MUN-Baja/2019_Comp/2019-05-26T074602.xlsx

Index | Quantity | Part Number | Manufacturer Part Number | Description | Customer Reference | Available | Backorder | Unit Price | Extended Price CAD
1 | 20 | 277-11117-ND | 3240016 | CONN RING CIRC 16-20AWG M3 CRIMP | CRIMP1 | 20 | 0 | 0.402 | 8.04
2 | 10 | 36-3522-ND | 3522 | FUSE CLIP BLADE 500V 30A PCB | F1 F2 F3 F4 F5 | 10 | 0 | 0.289 | 2.89
3 | 18 | 36-7771-ND | 7771 | TERM SCREW M3 4 PIN PCB | J1 J2 J3 J4 J5 J7 J8 J9 J10 J11 | 18 | 0 | 0.634 | 11.41
4 | 3 | F4193-ND | 0287003.PXCN | FUSE AUTO 3A 32VDC BLADE |  | 3 | 0 | 0.41 | 1.23
5 | 2 | F4199-ND | 0287010.PXCN | FUSE AUTOMOTIVE 10A 32VDC BLADE |  | 2 | 0 | 0.41 | 0.82
6 | 2 | F4201-ND | 0287020.PXCN | FUSE AUTOMOTIVE 20A 32VDC BLADE |  | 2 | 0 | 0.41 | 0.82
7 | 1 | F4197-ND | 0287005.PXCN | FUSE AUTO 5A 32VDC BLADE ATO/ATC |  | 1 | 0 | 0.41 | 0.41
8 | 1 | F4200-ND | 0287015.PXCN | FUSE AUTOMOTIVE 15A 32VDC BLADE |  | 1 | 0 | 0.41 | 0.41
9 | 1 | F4203-ND | 0287040.PXCN | FUSE AUTOMOTIVE 40A 32VDC BLADE |  | 1 | 0 | 0.41 | 0.41
10 | 1 | F4198-ND | 028707.5PXCN | FUSE AUTOMOTIVE 7.5A 32VDC BLADE |  | 1 | 0 | 0.41 | 0.41
11 | 2 | F4191-ND | 0287001.PXCN | FUSE AUTO 1A 32VDC BLADE |  | 2 | 0 | 0.41 | 0.82
12 | 4 | RPC3022-ND | CBTS105A | HEX STANDOFF M3 NYLON 22MM |  | 4 | 0 | 2.03 | 8.12
13 | 25 | 455-2266-ND | XHP-2 | CONN HOUSING 2.5MM 2POS |  | 25 | 0 | 0.0952 | 2.38
14 | 25 | 455-2247-ND | B2B-XH-A(LF)(SN) | CONN HEADER VERT 2POS 2.5MM |  | 25 | 0 | 0.205 | 5.13
15 | 100 | 455-1135-1-ND | SXH-001T-P0.6 | CONN SOCKET 22-28AWG CRIMP TIN |  | 100 | 0 | 0.0561 | 5.61
16 | 10 | 455-2219-ND | XHP-3 | CONN HOUSING 2.5MM XH 3POS |  | 10 | 0 | 0.142 | 1.42
17 | 10 | 455-2248-ND | B3B-XH-A(LF)(SN) | CONN HEADER VERT 3POS 2.5MM |  | 10 | 0 | 0.263 | 2.63
18 | 1 | 455-2268-ND | XHP-5 | CONN HOUSING 2.5MM 5POS |  | 1 | 0 | 0.17 | 0.17
19 | 1 | 455-2270-ND | B5B-XH-A(LF)(SN) | CONN HEADER VERT 5POS 2.5MM |  | 1 | 0 | 0.36 | 0.36
20 | 2 | 1568-1816-ND | PRT-10474 | XT60 CONNECTORS MALE/FEMALE PAIR |  | 2 | 0 | 2.18 | 4.36
21 | 1 | 36-3034-ND | 3034 | BATTERY RETAINER COIN 20MM SMD | BT1 | 1 | 0 | 0.45 | 0.45
22 | 3 | 1276-6471-1-ND | CL21B105KOFNNNG | CAP CER 1UF 16V X7R 0805 | C1 C2 C9 | 3 | 0 | 0.15 | 0.45
23 | 1 | 1276-6464-1-ND | CL21A475KPFNNNG | CAP CER 4.7UF 10V X5R 0805 | C8 | 1 | 0 | 0.19 | 0.19
24 | 1 | 1528-1074-ND | 85 | STACKING HEADER ARDUINO SHIELD | J10 | 1 | 0 | 2.83 | 2.83
25 | 1 | HR1941CT-ND | DM3D-SF | CONN MICRO SD CARD PUSH-PULL | J4 | 1 | 0 | 2.54 | 2.54
26 | 1 | 455-2257-ND | S2B-XH-A(LF)(SN) | CONN HEADER R/A 2POS 2.5MM | J1 | 1 | 0 | 0.25 | 0.25
27 | 1 | 311-0.0ARCT-ND | RC0805JR-070RL | RES SMD 0 OHM JUMPER 1/8W 0805 | R3 | 1 | 0 | 0.15 | 0.15
28 | 2 | 311-200ARCT-ND | RC0805JR-07200RL | RES SMD 200 OHM 5% 1/8W 0805 | R4 R5 | 2 | 0 | 0.15 | 0.30
29 | 2 | 311-4.7KARCT-ND | RC0805JR-074K7L | RES SMD 4.7K OHM 5% 1/8W 0805 | R1 R2 | 2 | 0 | 0.15 | 0.30
30 | 1 | 1727-6331-1-ND | 74HC4050D,653 | IC BUFFER NON-INVERT 6V 16SO | U4 | 1 | 0 | 0.7 | 0.70
31 | 1 | AZ1117EH-3.3TRG1DICT-ND | AZ1117EH-3.3TRG1 | IC REG LINEAR 3.3V 1A SOT223 | U2 | 1 | 0 | 0.66 | 0.66
32 | 1 | 455-2251-ND | B8B-XH-A(LF)(SN) | CONN HEADER VERT 8POS 2.5MM | U5 | 1 | 0 | 0.52 | 0.52
33 | 1 | 535-9034-ND | AB38T-32.768KHZ | CRYSTAL 32.7680KHZ 12.5PF T/H | Y1 | 1 | 0 | 0.26 | 0.26
34 | 1 | L10005-ND | 5100H5 | LED GREEN 1/4" HOLE PANEL MOUNT |  | 1 | 0 | 2.15 | 2.15
35 | 1 | L10001-ND | 5100H1 | LED RED 1/4" HOLE PANEL MOUNT |  | 1 | 0 | 2.15 | 2.15
36 | 1 | 455-1902-ND | XHP-8 | CONN HOUSING XH 8POS 2.5MM |  | 1 | 0 | 0.23 | 0.23
37 | 1 | 455-2251-ND | B8B-XH-A(LF)(SN) | CONN HEADER VERT 8POS 2.5MM |  | 1 | 0 | 0.52 | 0.52
38 | 10 | 732-8026-1-ND | 885012207016 | CAP CER 0.1UF 10V X7R 0805 | C5 C6 C7 C10 C11 C12 | 10 | 0 | 0.064 | 0.64
39 | 10 | 587-1451-1-ND | EMK105B7104KV-F | CAP CER 0.1UF 16V X7R 0402 | C3 C4 | 10 | 0 | 0.032 | 0.32
40 | 10 | 455-2267-ND | XHP-4 | CONN HOUSING 2.5MM 4POS |  | 10 | 0 | 0.142 | 1.42
41 | 10 | 455-2249-ND | B4B-XH-A(LF)(SN) | CONN HEADER VERT 4POS 2.5MM |  | 10 | 0 | 0.282 | 2.82
