MUN-Baja/2019_Comp/Models/Speedo CLAMP.SLDPRT

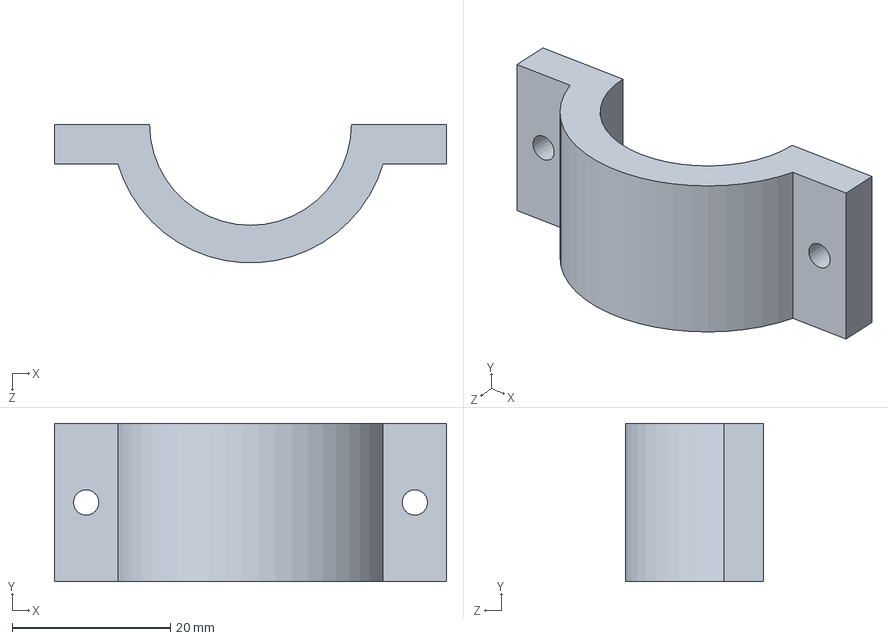
[picture p6: CAD file, 2019-06-01]
Models/Speedo CLAMP.SLDPRT
49.5 x 20.0 x 17.5 mm
