MUN-Baja/2019_Comp/Models/STLs/Speedo Mount_PART2.STL

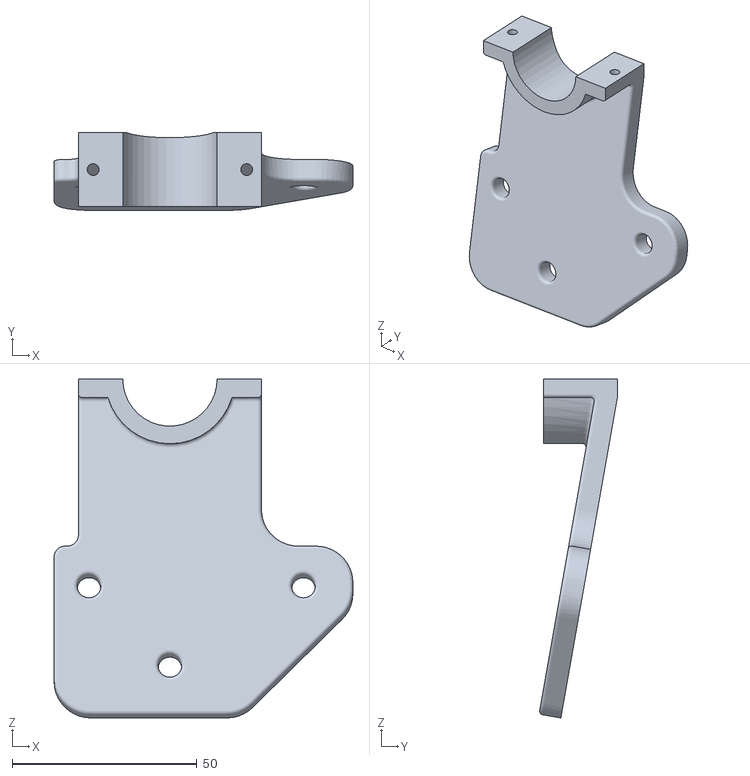
[picture p7: CAD file, 2019-06-01]
Models/STLs/Speedo Mount_PART2.STL
80.8 x 21.0 x 91.7
