MUN-Baja/2019_Comp/Models/Battery_Cover.SLDPRT

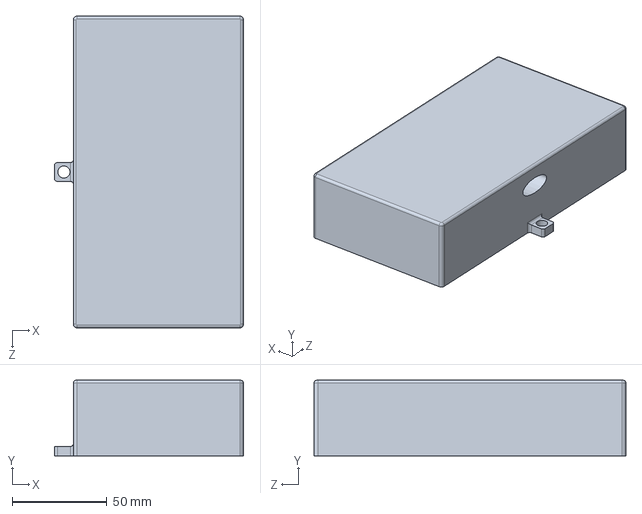
[picture p8: CAD file, 2019-05-29]
Models/Battery_Cover.SLDPRT
100.0 x 40.0 x 165.0 mm
