MUN-Baja/2019_Comp/Models/Battery_Base.SLDPRT

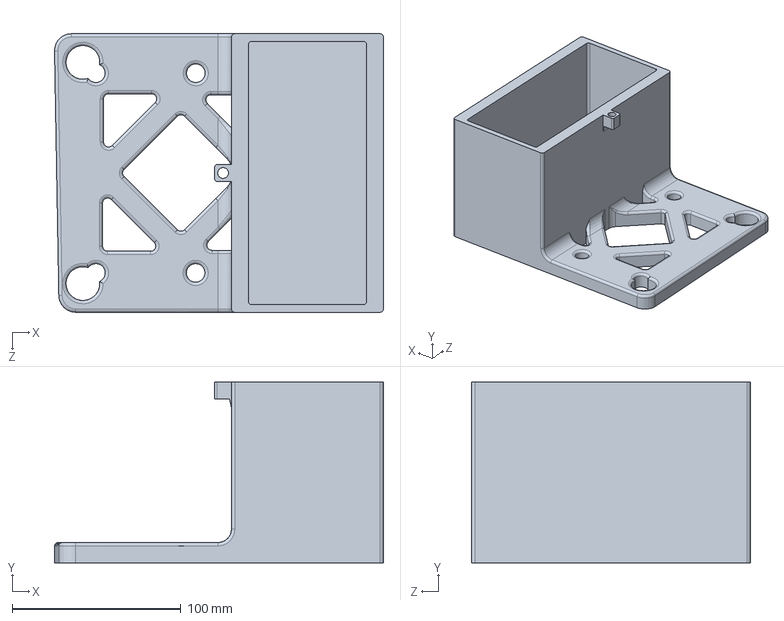
[picture p9: CAD file, 2019-05-29]
Models/Battery_Base.SLDPRT
194.8 x 107.0 x 165.0 mm
