MUN-Baja/2019_Comp/(list of files, cad)

Other CAD files:
Models/Speedo Mount.SLDPRT
Models/STLs/Battery_Base.STL
Models/STLs/Battery_Cover.STL
Models/STLs/Speedo CLAMP.STL
