MUN-Baja/2019_Comp/ControllerPCB/DOC/ControllerPCB.pdf

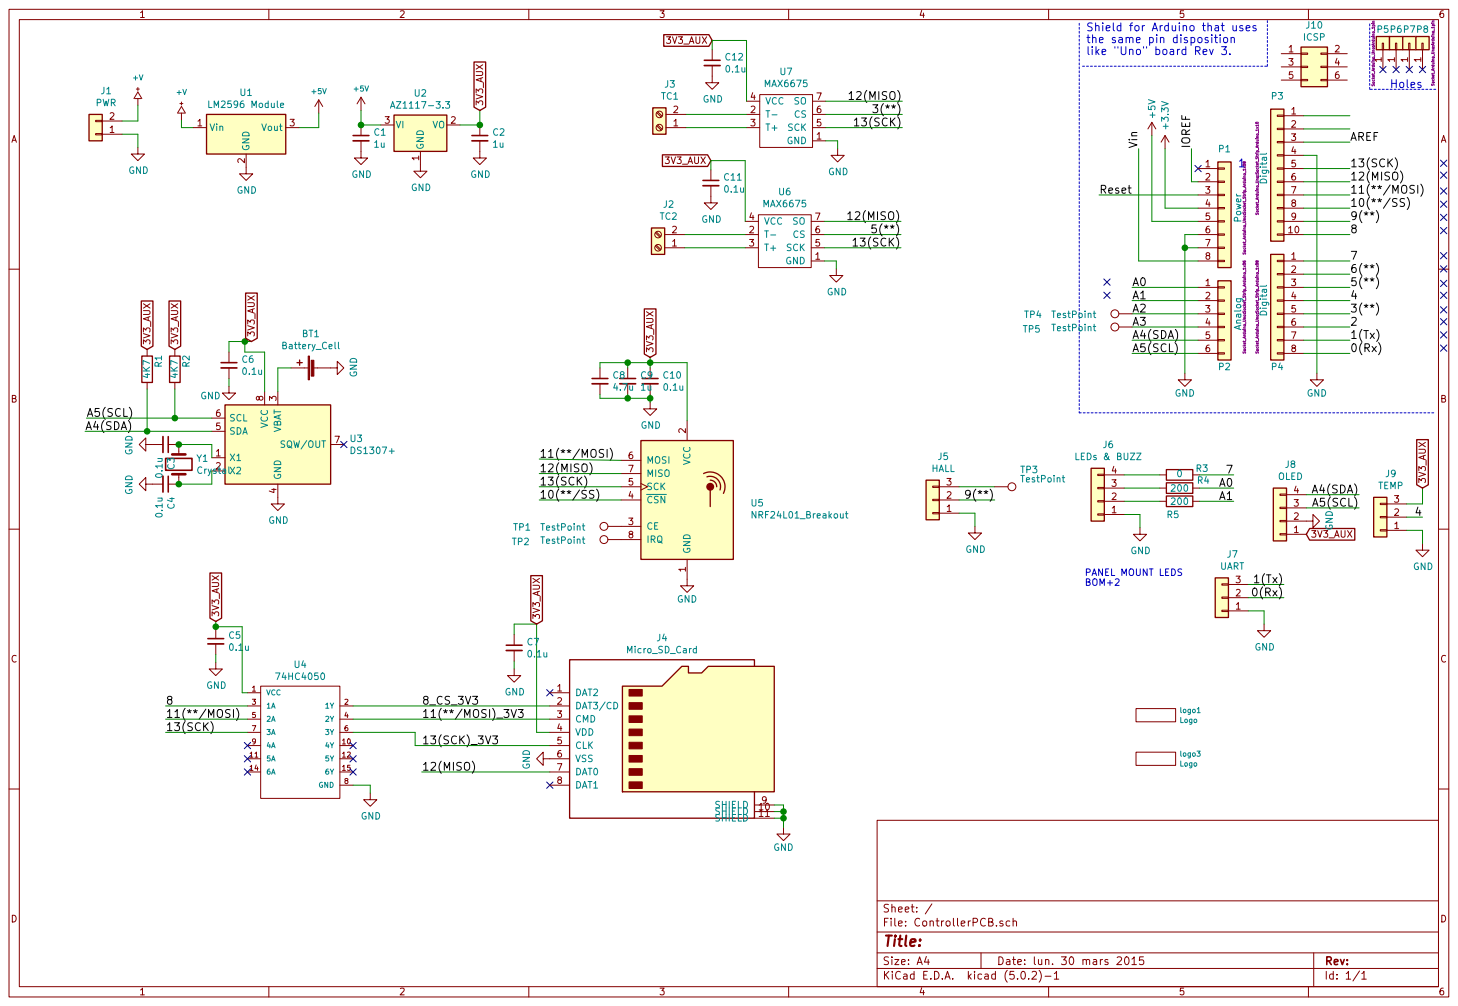
[picture p10: page 1]

the same pin disposition
like "Uno" board Rev 3. 1

4 SDA 5 SCL 6 SQW/OUT 7 VCC

2 CE 3 CSN 4 SCK 5 MOSI 6 MISO 7
