MUN-Baja/2019_Comp/FusePCB/FusePCB.kicad_pcb

## KiCad design FusePCB/FusePCB.kicad_pcb (2019-05-27)

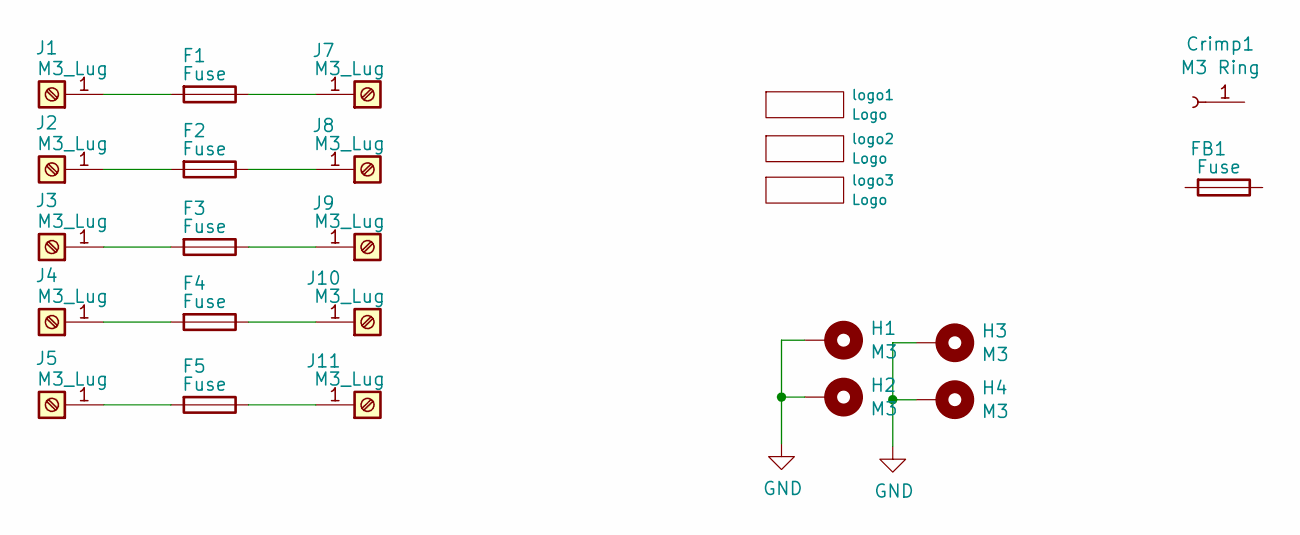
[picture p11: schematic FusePCB.sch]

Parts:
Crimp1: M3 Ring
F1, F2, F3, F4, F5: Fuse; Fuse_ATC_ATO_BLADE
FB1: Fuse
H1, H2, H3, H4: M3; 3.4mm_mounting_hole_SILK
J1, J2, J3, J4, J5, J7, J8, J9, J10, J11: M3_Lug; LVDC_M3_Lug
logo1, logo2: Logo; SN_BLOCK
logo3: Logo; KiCad-Logo_8mm_SilkScreen

Connections:
GND: H1.1, H2.1, H3.1, H4.1
unnamed: F1.1, J7.1
unnamed: F1.2, J1.1
unnamed: F2.1, J8.1
unnamed: F2.2, J2.1
unnamed: F3.1, J9.1
unnamed: F3.2, J3.1
unnamed: F4.1, J10.1
unnamed: F4.2, J4.1
unnamed: F5.1, J11.1
unnamed: F5.2, J5.1

Board: 2 copper layers, 22 parts (1 on the bottom side), 11 nets, no tracks yet.
