MUN-Baja/2019_Comp/PowerPCB/PowerPCB.kicad_pcb

## KiCad design PowerPCB/PowerPCB.kicad_pcb (2019-05-27)

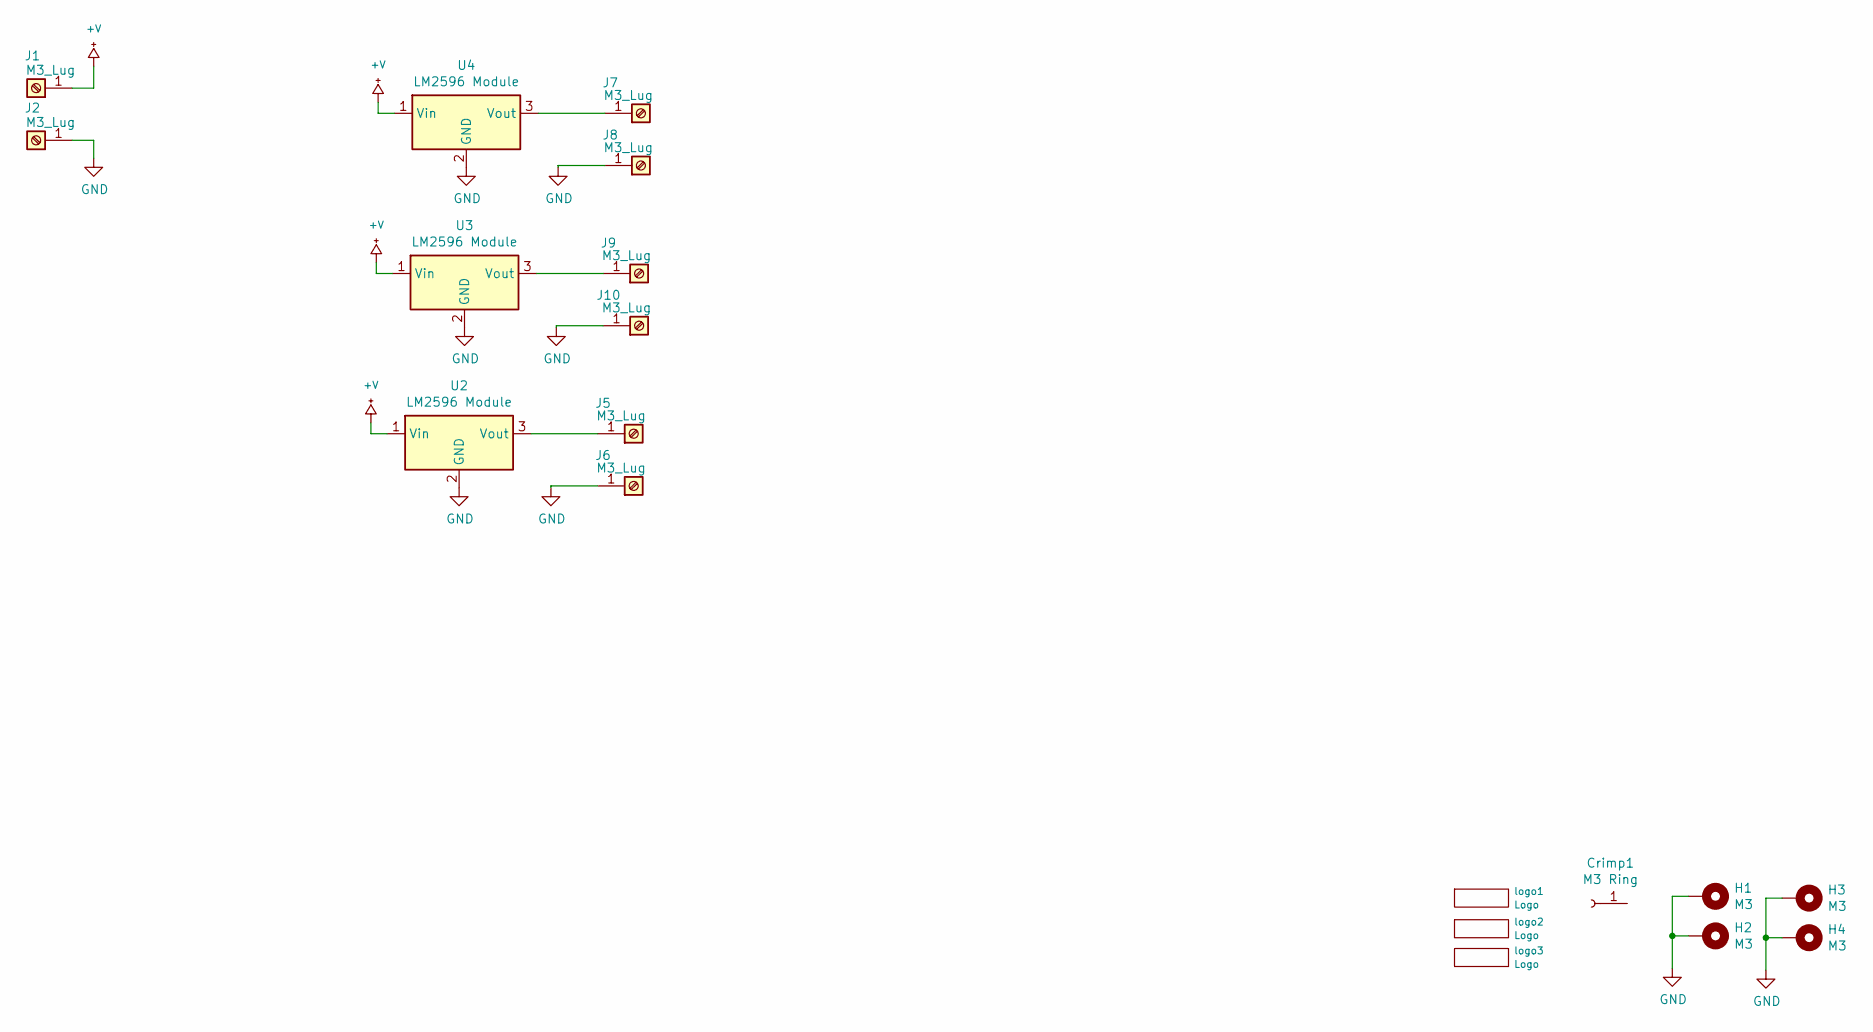
[picture p12: schematic PowerPCB.sch]

Parts:
Crimp1: M3 Ring
H1, H2, H3, H4: M3; 3.4mm_mounting_hole_SILK
J1, J2, J5, J6, J7, J8, J9, J10: M3_Lug; LVDC_M3_Lug
U2, U3, U4: LM2596 Module; LM2596_Module
logo1, logo2: Logo; SN_BLOCK
logo3: Logo; KiCad-Logo_8mm_SilkScreen

Connections:
+V: J1.1, U2.1 (Vin), U3.1 (Vin), U4.1 (Vin)
GND: H1.1, H2.1, H3.1, H4.1, J2.1, J6.1, J8.1, J10.1, U2.2 (GND), U3.2 (GND), U4.2 (GND)
unnamed: J5.1, U2.3 (Vout)
unnamed: J7.1, U4.3 (Vout)
unnamed: J9.1, U3.3 (Vout)

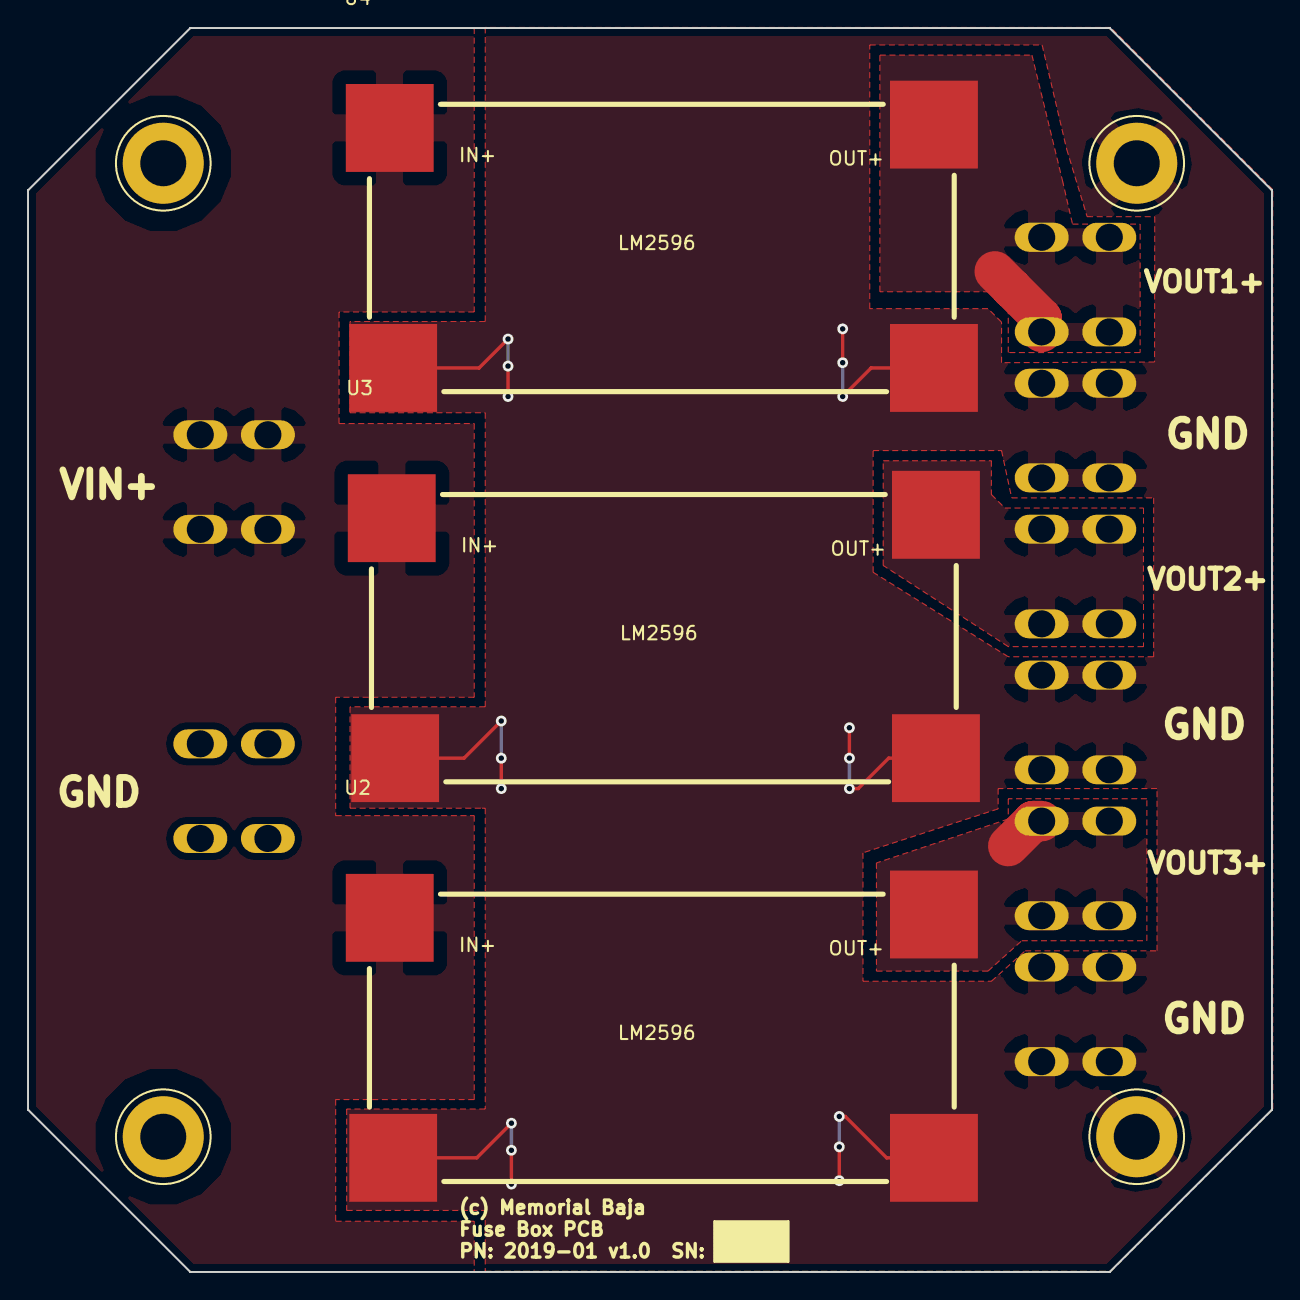
[picture p13: board PowerPCB.kicad_pcb from above]

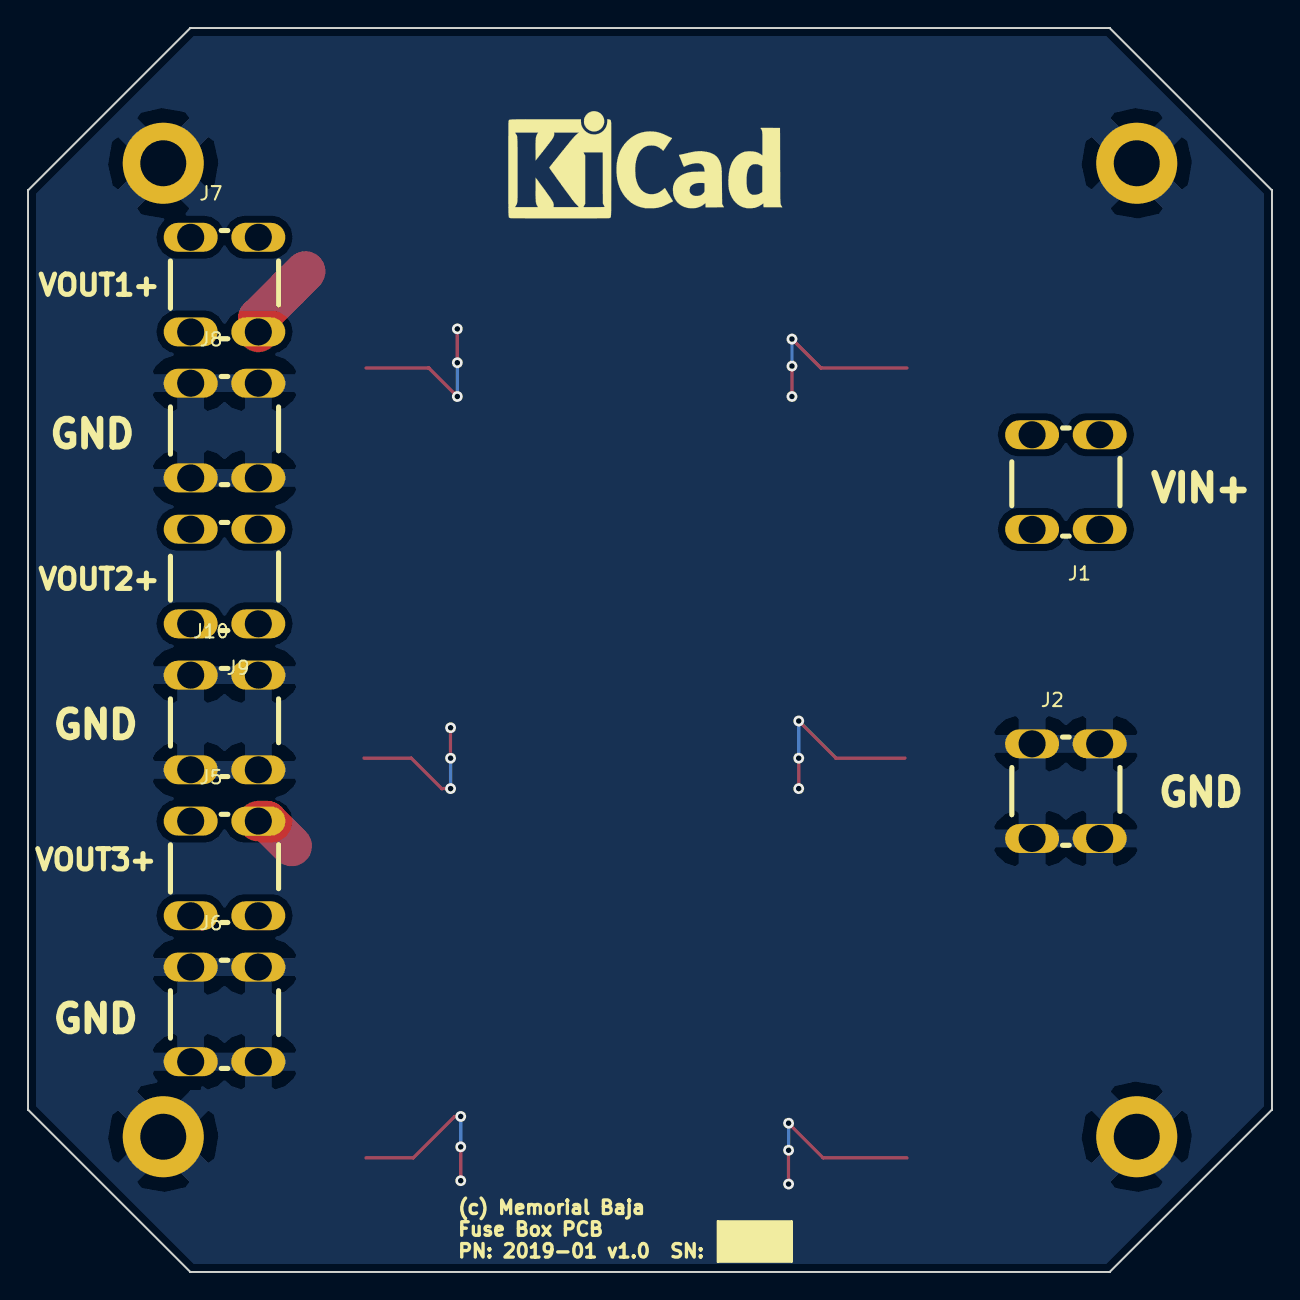
[picture p14: board PowerPCB.kicad_pcb from below]

Board: 2 copper layers, 92.0 x 92.0 mm, 18 parts (10 on the bottom side), 5 nets.
