MUN-Baja/2019_Comp/ControllerPCB/ControllerPCB.kicad_pcb

## KiCad design ControllerPCB/ControllerPCB.kicad_pcb (2019-05-27)

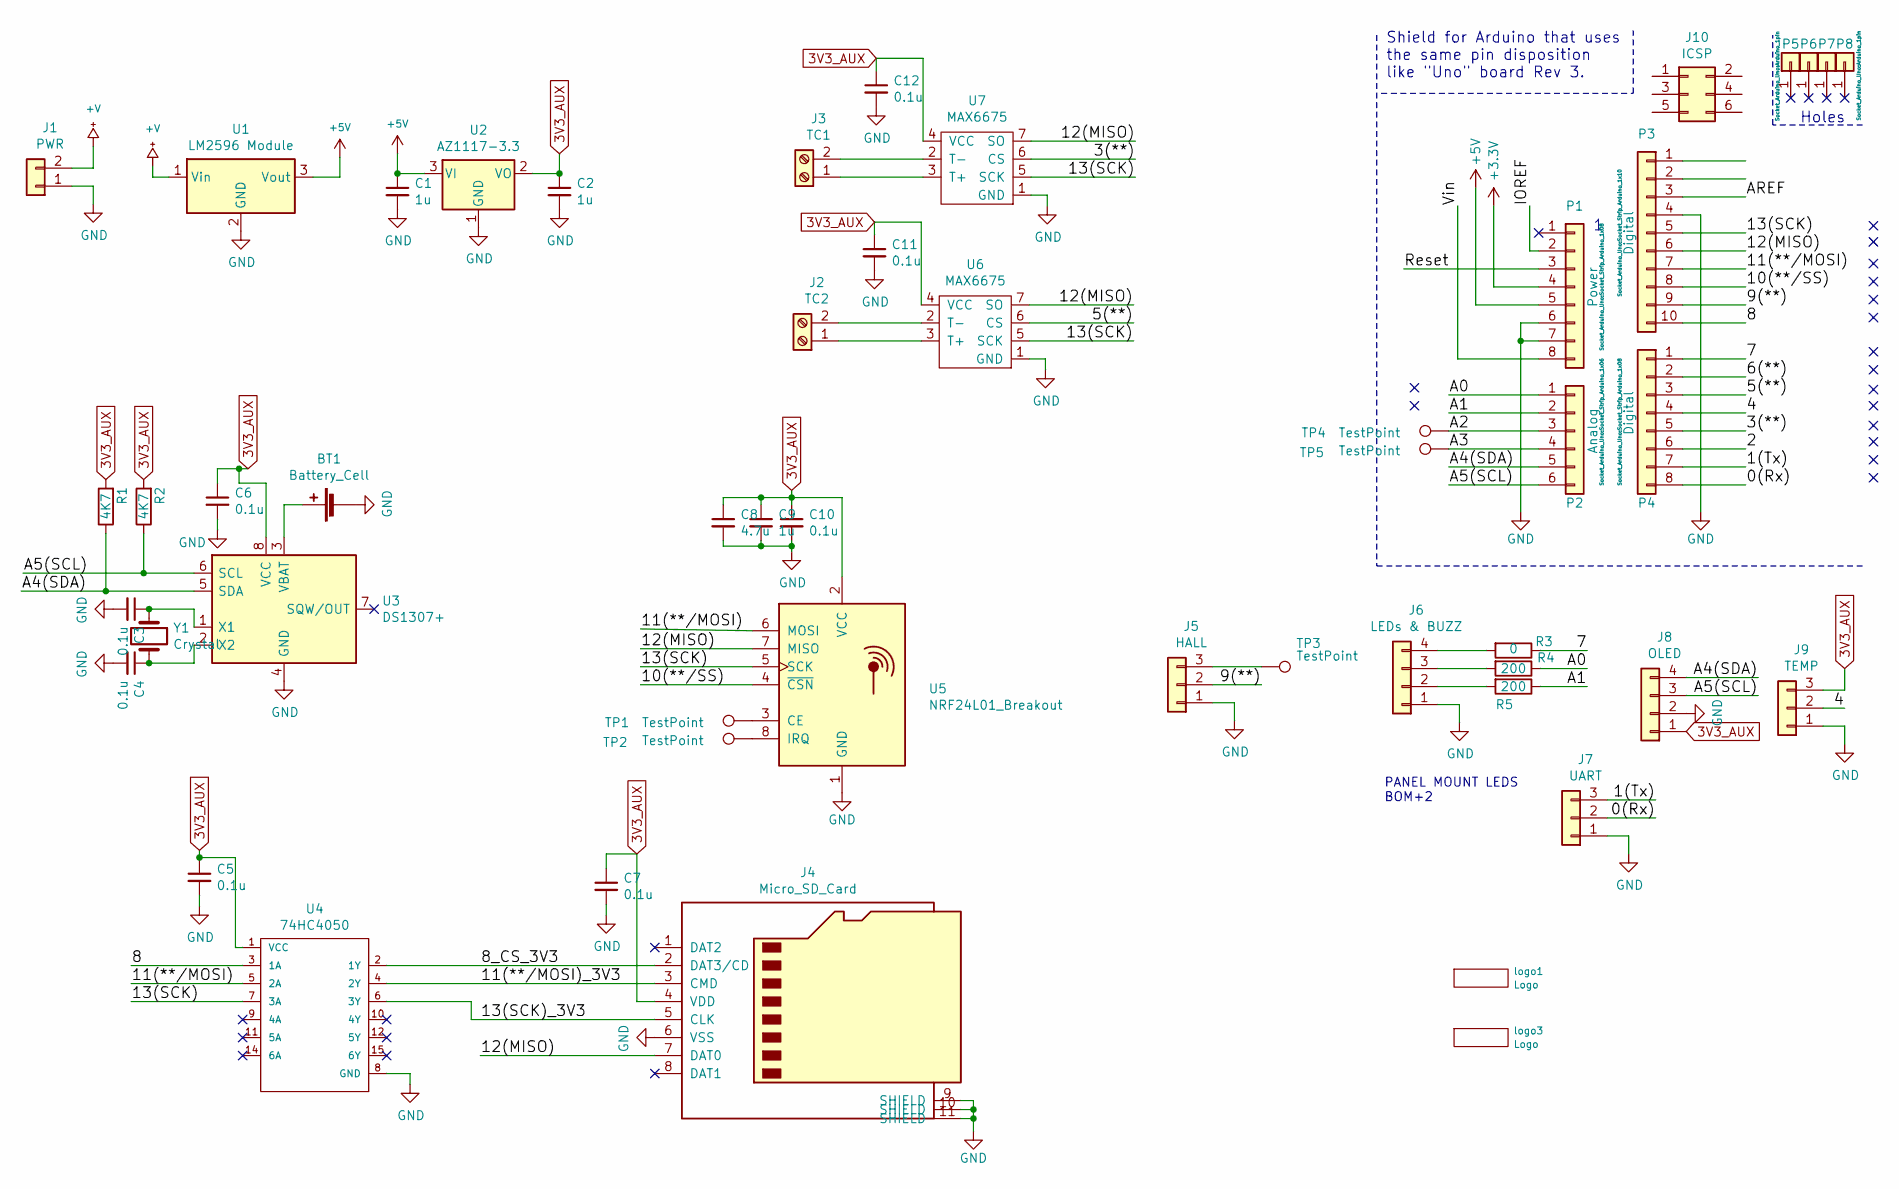
[picture p15: schematic ControllerPCB.sch]

Parts:
BT1: Battery_Cell; Keystone_3034_1x20mm-CoinCell
C1, C2, C9: 1u; SMD_pkg_0805
C3, C4: 0.1u; R_0402
C5, C6, C7, C10, C11, C12: 0.1u; SMD_pkg_0805
C8: 4.7u; SMD_pkg_0805
J1: PWR; JST_XH_S02B-XH-A_02x2.50mm_Angled
J2: TC2; TerminalBlock_RND_205-00232_1x02_P5.08mm_Horizontal
J3: TC1; TerminalBlock_RND_205-00232_1x02_P5.08mm_Horizontal
J4: Micro_SD_Card; Hirose_DM3D-SF
J5: HALL; Pin_Header_Straight_1x03_Pitch1.27mm
J6: LEDs & BUZZ; Pin_Header_Straight_1x04_Pitch1.27mm
J7: UART; Pin_Header_Straight_1x03_Pitch1.27mm
J8: OLED; Pin_Header_Straight_1x04_Pitch1.27mm
J9: TEMP; JST_XH_B03B-XH-A_03x2.50mm_Straight
J10: ICSP; Pin_Header_Straight_2x03_Pitch2.54mm
P1: Power; Socket_Strip_Arduino_1x08
P2: Analog; Socket_Strip_Arduino_1x06
P3: Digital; Socket_Strip_Arduino_1x10
P4: Digital; Socket_Strip_Arduino_1x08
P5, P6, P7, P8: CONN_01X01; Arduino_1pin
R1, R2: 4K7; SMD_pkg_0805
R3: 0; SMD_pkg_0805
R4, R5: 200; SMD_pkg_0805
TP1, TP2, TP3, TP4, TP5: TestPoint; Testpoint_circle_0.5mm
U1: LM2596 Module; LM2596_Module
U2: AZ1117-3.3; SOT-223-3_TabPin2
U3: DS1307+; SOIC-8_N
U4: 74HC4050; SOIC-16_N
U5: NRF24L01_Breakout; JST_XH_B08B-XH-A_08x2.50mm_Straight
U6, U7: MAX6675; SOIC-8_N
Y1: Crystal; Crystal_C38-LF_d3.0mm_l8.0mm_Horizontal
logo1: Logo; SN_BLOCK
logo3: Logo; KiCad-Logo_8mm_SilkScreen

Connections:
3V3_AUX: C2.1, C5.1, C6.1, C7.1, C8.1, C9.1, C10.1, C11.1, C12.1, J4.4 (VDD), J8.1, J9.3, R1.2, R2.2, U2.2 (VO), U3.8 (VCC), U4.1 (VCC), U5.2 (VCC), U6.4 (VCC), U7.4 (VCC)
+3V3: P1.4
+5V: C1.1, P1.5, U1.3 (Vout), U2.3 (VI)
+V: J1.2, U1.1 (Vin)
/0(Rx): J7.2, P4.8
/1(Tx): J7.3, P4.7
/2: P4.6
/3(**): P4.5, U7.6 (CS)
/4: J9.2, P4.4
/5(**): P4.3, U6.6 (CS)
/6(**): P4.2
/7: P4.1, R3.1
/8: P3.10, U4.3 (1A)
/8_CS_3V3: J4.2 (DAT3/CD), U4.2 (1Y)
/9(**): J5.2, P3.9
/10(**/SS): P3.8, U5.4 (~CSN)
/11(**/MOSI): P3.7, U4.5 (2A), U5.6 (MOSI)
/11(**/MOSI)_3V3: J4.3 (CMD), U4.4 (2Y)
/12(MISO): J4.7 (DAT0), P3.6, U5.7 (MISO), U6.7 (SO), U7.7 (SO)
/13(SCK): P3.5, U4.7 (3A), U5.5 (SCK), U6.5 (SCK), U7.5 (SCK)
/13(SCK)_3V3: J4.5 (CLK), U4.6 (3Y)
/A0: P2.1, R4.1
/A1: P2.2, R5.1
/A2: P2.3, TP4.1
/A3: P2.4, TP5.1
/A4(SDA): J8.4, P2.5, R1.1, U3.5 (SDA)
/A5(SCL): J8.3, P2.6, R2.1, U3.6 (SCL)
/AREF: P3.3
/IOREF: P1.2
/Reset: P1.3
/Vin: P1.8
GND: BT1.2 (-), C1.2, C2.2, C3.2, C4.2, C5.2, C6.2, C7.2, C8.2, C9.2, C10.2, C11.2, C12.2, J1.1, J4.6 (VSS), J4.9 (SHIELD), J4.10 (SHIELD), J4.11 (SHIELD), J5.1, J6.1, J7.1, J8.2, J9.1, P1.6, P1.7, P3.4, U1.2 (GND), U2.1 (GND), U3.4 (GND), U4.8 (GND), U5.1 (GND), U6.1 (GND), U7.1 (GND)
unnamed: BT1.1 (+), U3.3 (VBAT)
unnamed: C3.1, U3.1 (X1), Y1.1
unnamed: C4.1, U3.2 (X2), Y1.2
unnamed: J2.1, U6.3 (T+)
unnamed: J2.2, U6.2 (T-)
unnamed: J3.1, U7.3 (T+)
unnamed: J3.2, U7.2 (T-)
unnamed: J5.3, TP3.1
unnamed: J6.2, R5.2
unnamed: J6.3, R4.2
unnamed: J6.4, R3.2
unnamed: TP1.1, U5.3 (CE)
unnamed: TP2.1, U5.8 (IRQ)

Notes on the sheet:
Holes
Shield for Arduino that uses the same pin disposition like "Uno" board Rev 3.
PANEL MOUNT LEDS BOM+2

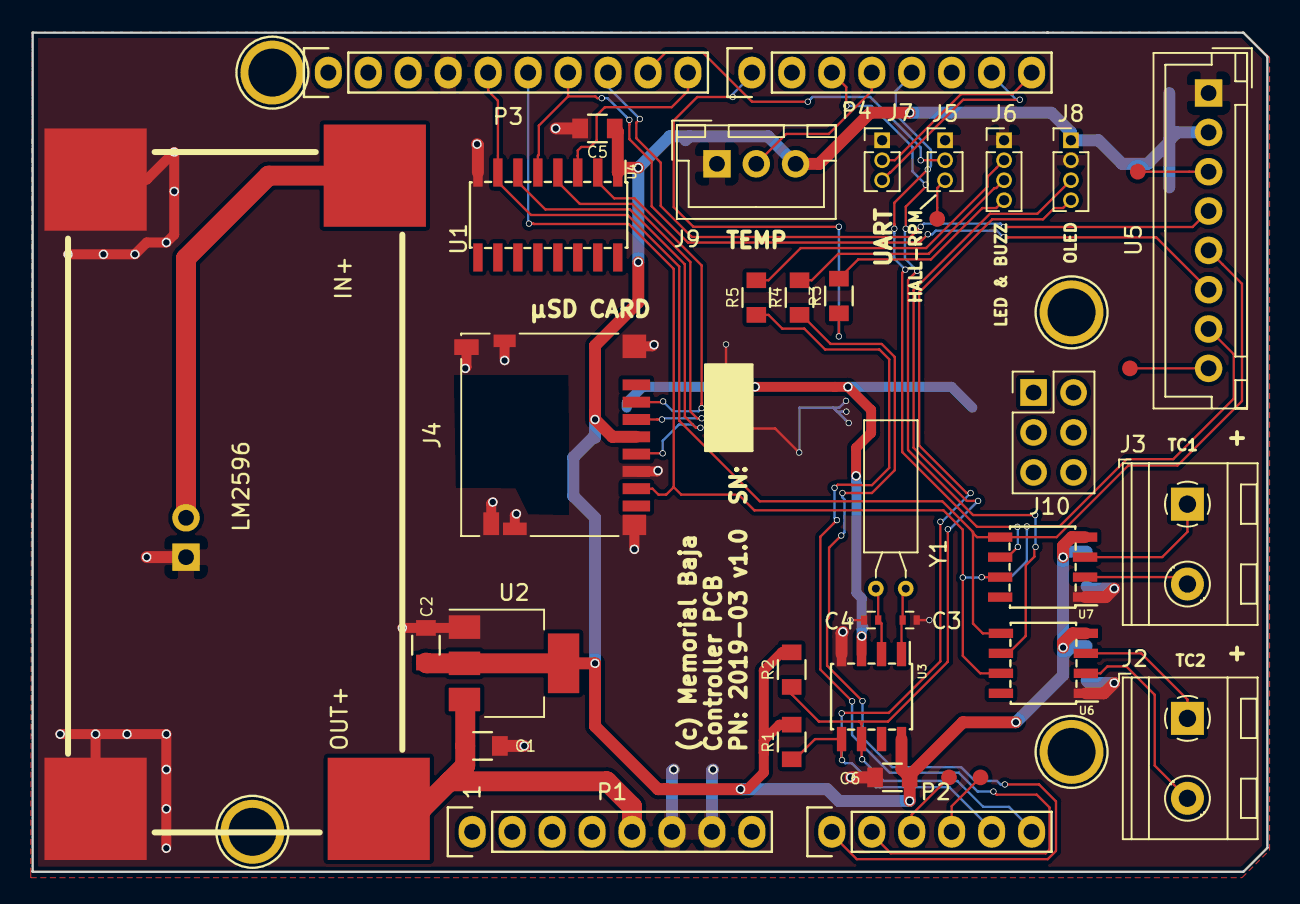
[picture p16: board ControllerPCB.kicad_pcb from above]

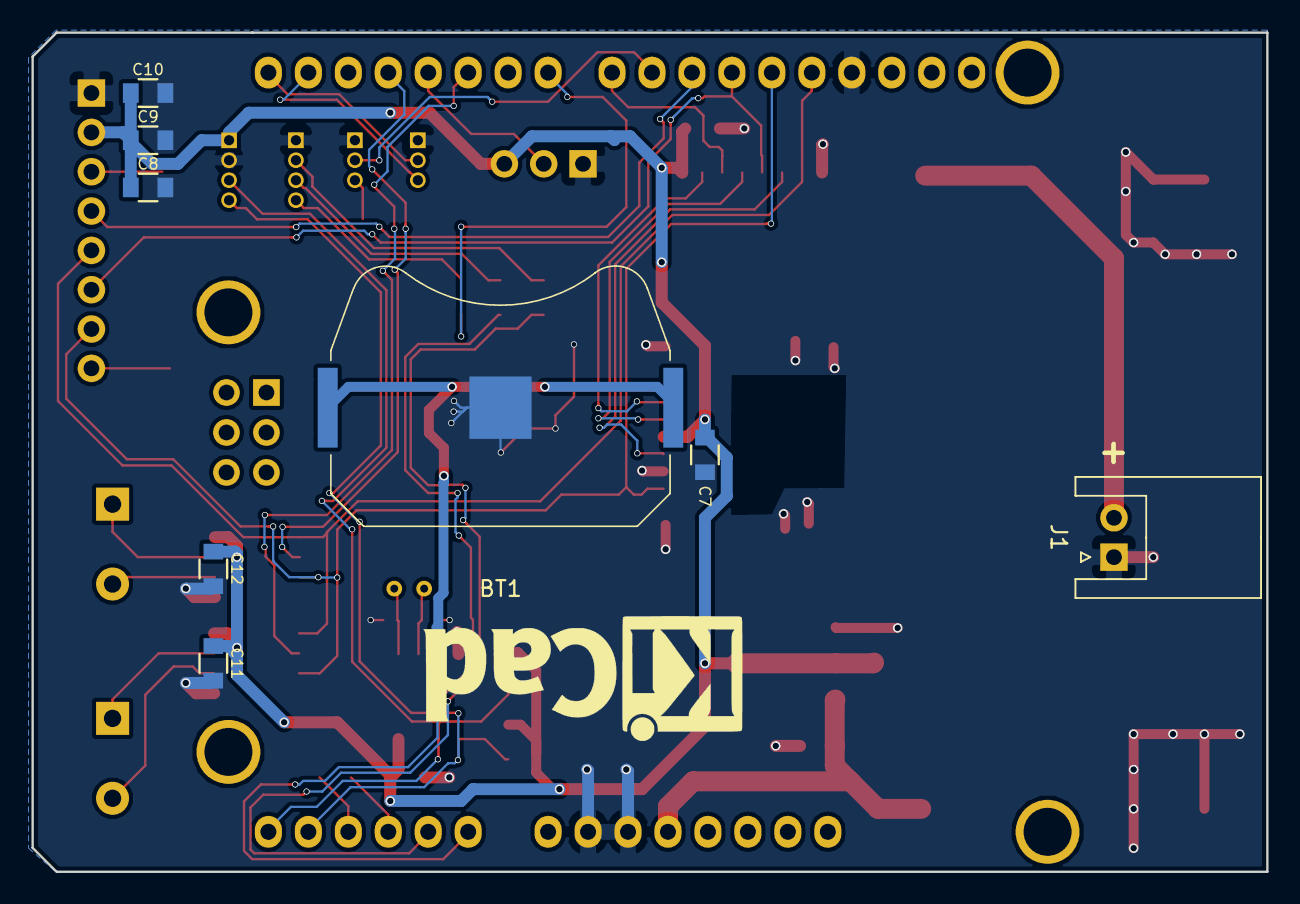
[picture p17: board ControllerPCB.kicad_pcb from below]

Board: 2 copper layers, 78.5 x 53.3 mm, 51 parts (9 on the bottom side), 38 nets.
