MUN-Baja/2019_Comp/ControllerPCB/CODE/2019_Controller/2019_Controller.ino

/*******************************************
   2019 Baja Uno Shield Controller
 ******************************************/

 // Libraries
//MAX6675
//DS1207+ RTC
//NRF Library
//SD Card
//DS18b20

// PIN ASSIGNMENTS
#define panelLED 7
//I2C
//SPI Devices

void setup() {
  // put your setup code here, to run once:

}

void loop() {
  // put your main code here, to run repeatedly:

}
