MUN-Baja/2019_Comp/(commit log)

2019-05-27 Uploading 3 comp PCBs finished
    [2019-05-26T074602.xlsx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]
2019-05-29 test models
    [Battery_Base.SLDPRT, Battery_Base.STL, Battery_Cover.SLDPRT, Battery_Cover.STL, Speedo Mount.SLDPRT, Speedo Mount.STL]
2019-06-01 added gcode for printed models
    [Speedo CLAMP.SLDPRT, Speedo CLAMP.STL, Speedo Mount.SLDPRT, Speedo Mount.STL, Speedo Mount_PART2.STL]
